liam-g-hub/bldc-esc_3-c1/3D/cap_el_horizontal_d10_h20_pitch5_w0.6.stp

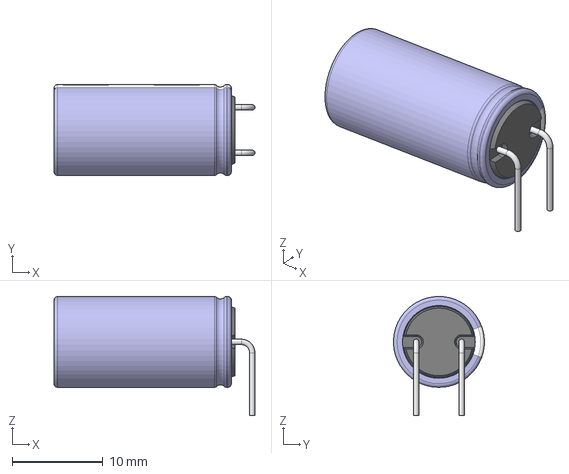
[picture p1: CAD file, 2025-09-13]
3D/cap_el_horizontal_d10_h20_pitch5_w0.6.stp
22.1 x 10.0 x 13.1 mm
