liam-g-hub/bldc-esc_3-c1/3D/shapes3D/XT60PW-M --3DModel-STEP-1.STEP

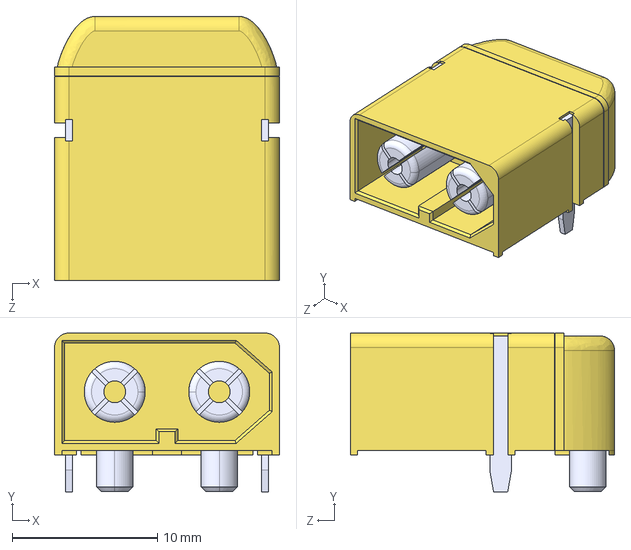
[picture p2: CAD file, 2025-09-13]
3D/shapes3D/XT60PW-M --3DModel-STEP-1.STEP
15.5 x 10.9 x 18.2 mm
