liam-g-hub/bldc-esc_3-c1/3D/TO-247H.step

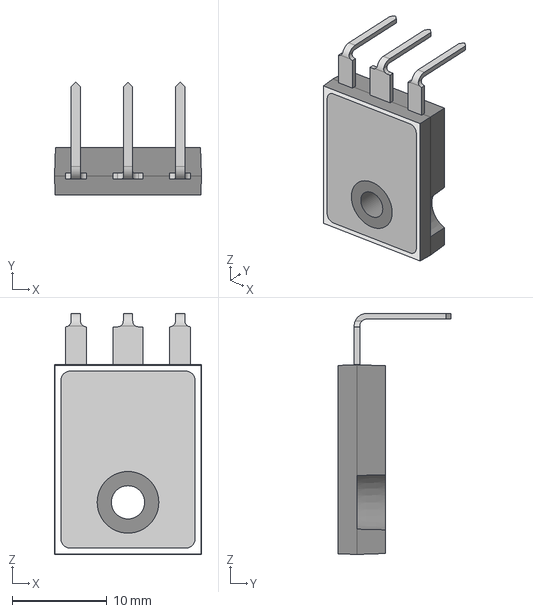
[picture p4: CAD file, 2025-09-13]
3D/TO-247H.step
15.5 x 11.9 x 25.4 mm
