liam-g-hub/bldc-esc_3-c1/(list of files, cad)

Other CAD files:
3D/cap_el_horizontal_d10_h20_pitch5_w0.step
3D/TO-247H.SLDPRT
