liam-g-hub/bldc-esc_3-c1/(list of files, drawings)

Other design files:
BLDC_4.dsn
