liam-g-hub/bldc-esc_3-c1/(commit log)

2025-09-13 3D directory added
    [TO-247H.SLDPRT, TO-247H.step, XT60PW-M --3DModel-STEP-1.STEP, cap_el_horizontal_d10_h20_pitch5_w0.6.stp, cap_el_horizontal_d10_h20_pitch5_w0.step, cap_el_horizontal_d10_h25_pitch5_w0.step]
2025-09-14 pdf schematic upload
